btaing14/VitalsPatch/ble-link-prototype/stm32/main.c

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
/* Includes ------------------------------------------------------------------*/
#include "main.h"
#include <stdio.h>
#include <string.h>

UART_HandleTypeDef huart2;

void SystemClock_Config(void);
static void MX_GPIO_Init(void);
static void MX_USART2_UART_Init(void);
/**
  * @brief  The application entry point.
  * @retval int
  */
int main(void)
{

  /* MCU Configuration--------------------------------------------------------*/

  /* Reset of all peripherals, Initializes the Flash interface and the Systick. */
  HAL_Init();

  /* Configure the system clock */
  SystemClock_Config();

  /* Initialize all configured peripherals */
  MX_GPIO_Init();
  MX_USART2_UART_Init();
  /* USER CODE BEGIN 2 */
  char msg[30];
  int counter = 0;
  uint8_t at_cmd[] = "AT+NAMESTM32BLE\r\n";
  uint8_t rx_data[2] = {0};

  HAL_GPIO_WritePin(GPIOD, GPIO_PIN_12, GPIO_PIN_RESET);

  HAL_UART_Transmit(&huart2, at_cmd, 2, HAL_MAX_DELAY);

  if (HAL_UART_Receive(&huart2, rx_data, 2, 3000) == HAL_OK)
  {
      if (rx_data[0] == 'O' && rx_data[1] == 'K')
      {
          HAL_GPIO_WritePin(GPIOD, GPIO_PIN_12, GPIO_PIN_SET);
      }
  }

  /* USER CODE END 2 */

  /* Infinite loop */
  /* USER CODE BEGIN WHILE */

  // ******************WRITE******************

  //while (1)
  //{
    /* USER CODE END WHILE */
	 //sprintf(msg, "Counter=%d\r\n", counter++);
	 //HAL_UART_Transmit(&huart2, (uint8_t*)msg, strlen(msg), HAL_MAX_DELAY);
	 //HAL_Delay(1000);
    /* USER CODE BEGIN 3 */
  //}
  /* USER CODE END 3 */

  // ******************READ******************

  uint8_t rx_byte;

  while (1)
  {
    if (HAL_UART_Receive(&huart2, &rx_byte, 1, HAL_MAX_DELAY) == HAL_OK)
    {
      if (rx_byte == '1')
      {
        HAL_GPIO_WritePin(GPIOD, GPIO_PIN_12, GPIO_PIN_SET);   // green LED ON
      }
      else if (rx_byte == '0')
      {
        HAL_GPIO_WritePin(GPIOD, GPIO_PIN_12, GPIO_PIN_RESET); // green LED OFF
      }
    }
  }
}

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
