btaing14/VitalsPatch/ble-link-prototype/stm32/HM19_Test.ioc

Mcu.UserName=STM32F407VGTx
PA2.Signal=USART2_TX
PA3.Signal=USART2_RX
