btaing14/VitalsPatch/(notices)

Notices in the files:
ble-link-prototype/stm32/main.c:
Copyright (c) 2026 STMicroelectronics.
All rights reserved.
This software is licensed under terms that can be found in the LICENSE file
